lanmilab/flick_music/arduino/README.md

Source code for arduino [flick_music](https://www.hackster.io/lanmiLab/make-musical-instrument-using-arduino-and-flick-large-e2890b) project.
