lanmilab/flick_music/shield_pcb/Outputs/flick_music_bot.jpg

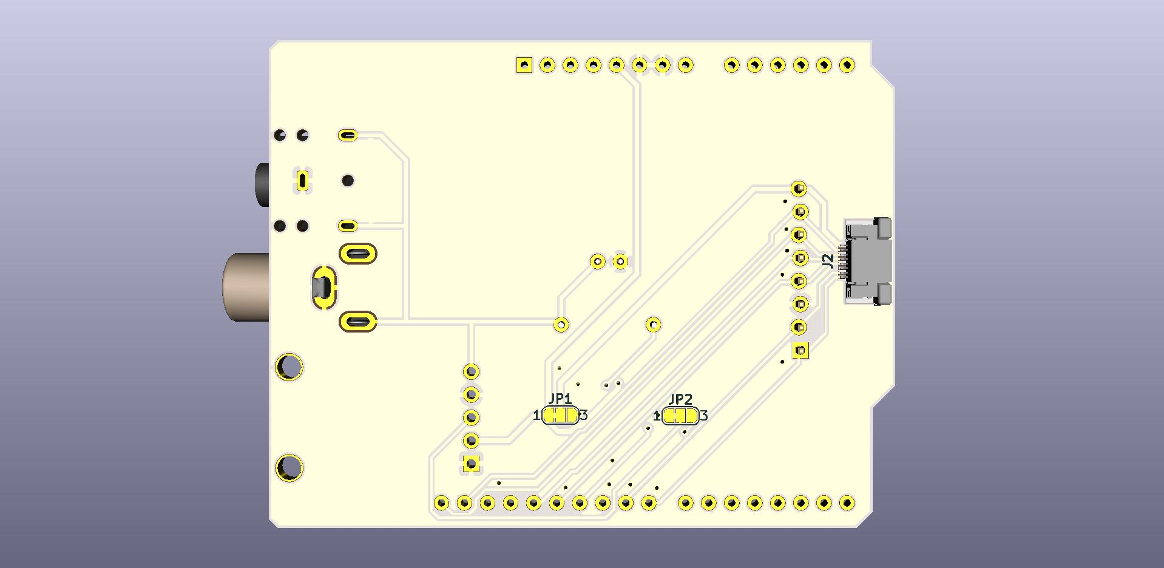
shield_pcb/Outputs/flick_music_bot.jpg
