lanmilab/flick_music/shield_pcb/Outputs/flick_music.pdf

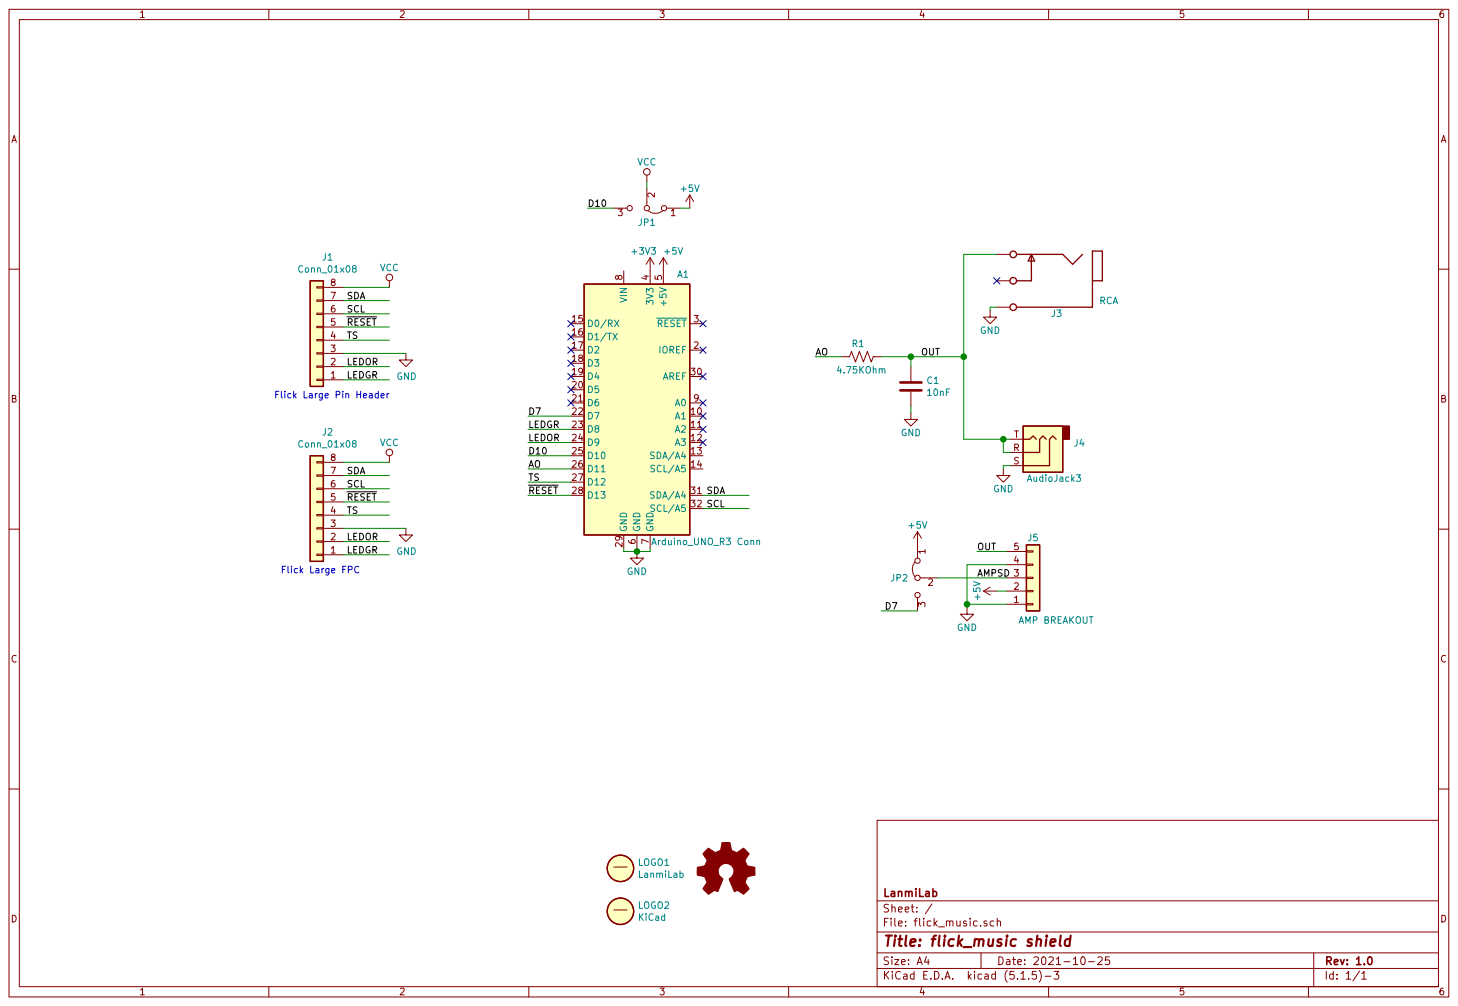
[picture p3: page 1]

Flick Large Pin Header

J5 AMP BREAKOUT GND GND GND

File: flick_music.sch Sheet: / LanmiLab
