lanmilab/flick_music/shield_pcb/flick_music.kicad_pcb

## KiCad design shield_pcb/flick_music.kicad_pcb (2021-10-25)

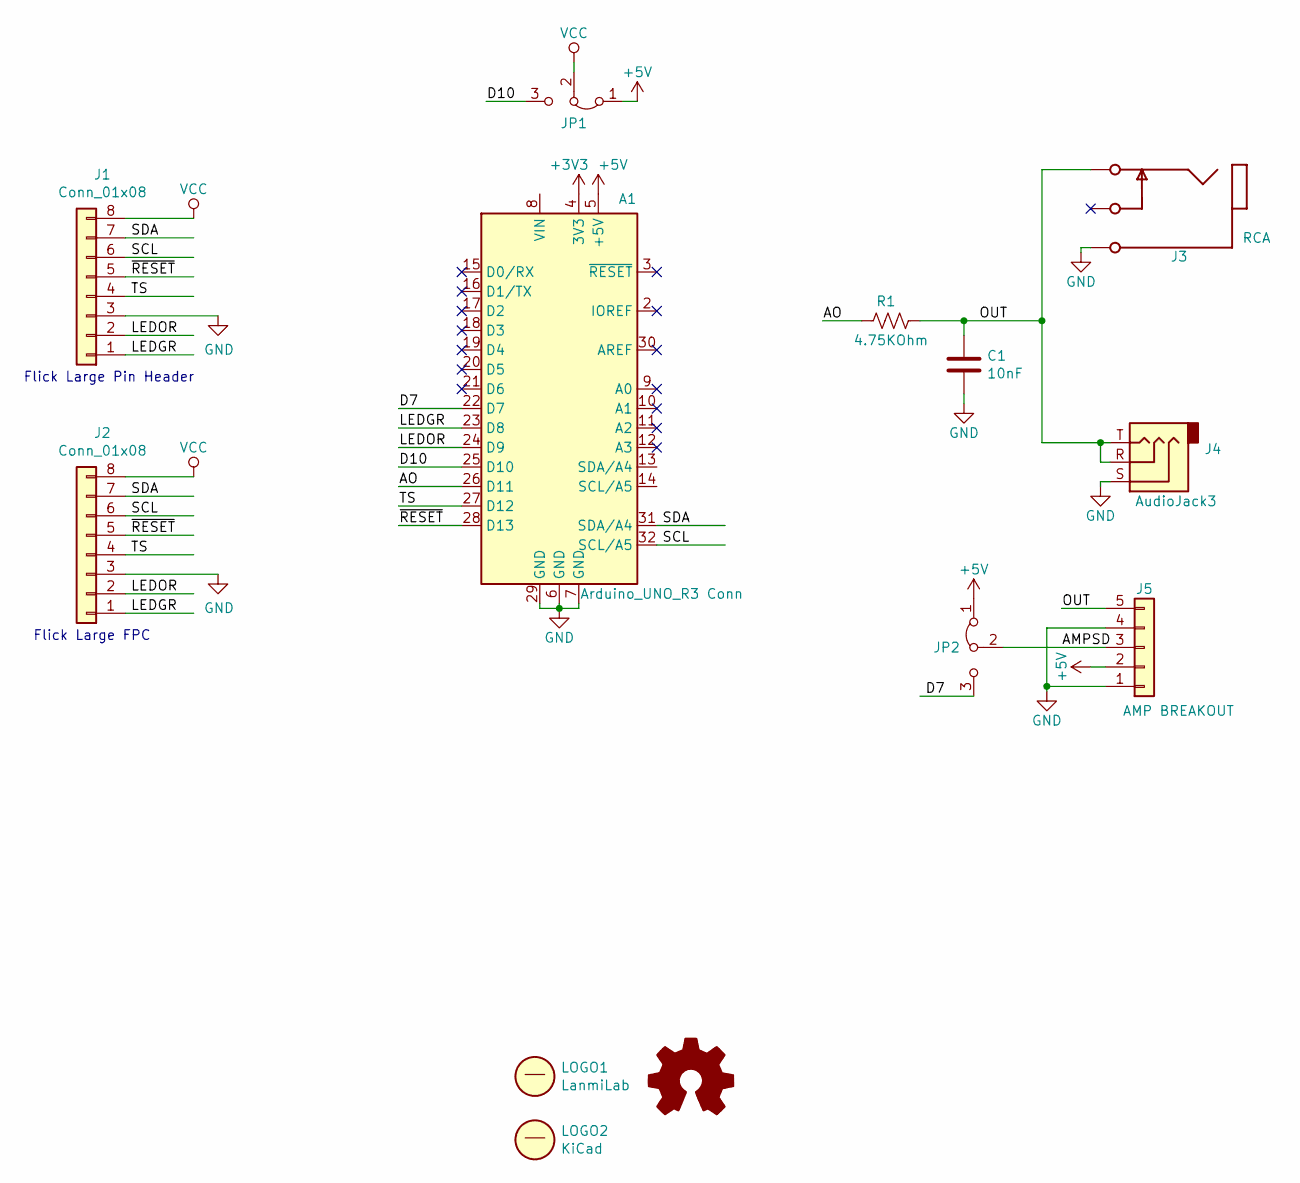
[picture p4: schematic flick_music.sch, flick_music shield]

Parts:
A1: Arduino_UNO_R3 Conn; Arduino_UNO_R3; Part Number M20-9994045
C1: 10nF; C_Disc_D3.8mm_W2.6mm_P2.50mm; Part Number C315C103K1R5TA
J1: Conn_01x08; PinHeader_1x08_P2.54mm_Horizontal; Part Number 68016-208HLF
J2: Conn_01x08; TE_0-1734839-8_1x08-1MP_P0.5mm_Horizontal; Part Number 0-1734839-8
J3: RCA; PJRAN1X1U01X; Part Number PJRAN1X1U01X
J4: AudioJack3; FC68131CLIFF; Part Number FC68131
J5: AMP BREAKOUT; PinSocket_1x05_P2.54mm_Vertical; Part Number PAM8302A Adafruit
JP1, JP2: Jumper_3_Bridged12; SolderJumper-3_P1.3mm_Bridged12_RoundedPad1.0x1.5mm_NumberL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
LOGO1: LanmiLab
LOGO2: KiCad; Logo_KiCad
LOGO3: Logo_Open_Hardware_Small; OSHW-Logo2_7.3x6mm_SilkScreen
R1: 4.75KOhm; R_Axial_DIN0207_L6.3mm_D2.5mm_P10.16mm_Horizontal; Part Number MCMF0W4FF4751A50

Connections:
+3V3: A1.4 (3V3)
+5V: A1.5 (+5V), J5.2, JP1.1 (A), JP2.1 (A)
/AMPSD: J5.3, JP2.2 (C)
/AO: A1.26 (D11), R1.2
/D7: A1.22 (D7), JP2.3 (B)
/D10: A1.25 (D10), JP1.3 (B)
/LEDGR: A1.23 (D8), J1.1, J2.1
/LEDOR: A1.24 (D9), J1.2, J2.2
/OUT: C1.1, J3.2, J4.R, J4.T, J5.5, R1.1
/SCL: A1.32 (SCL/A5), J1.6, J2.6
/SDA: A1.31 (SDA/A4), J1.7, J2.7
/TS: A1.27 (D12), J1.4, J2.4
/~RESET: A1.28 (D13), J1.5, J2.5
GND: A1.6 (GND), A1.7 (GND), A1.29 (GND), C1.2, J1.3, J2.3, J3.1, J4.S, J5.1, J5.4
VCC: J1.8, J2.8, JP1.2 (C)

Notes on the sheet:
Flick Large FPC
Flick Large Pin Header

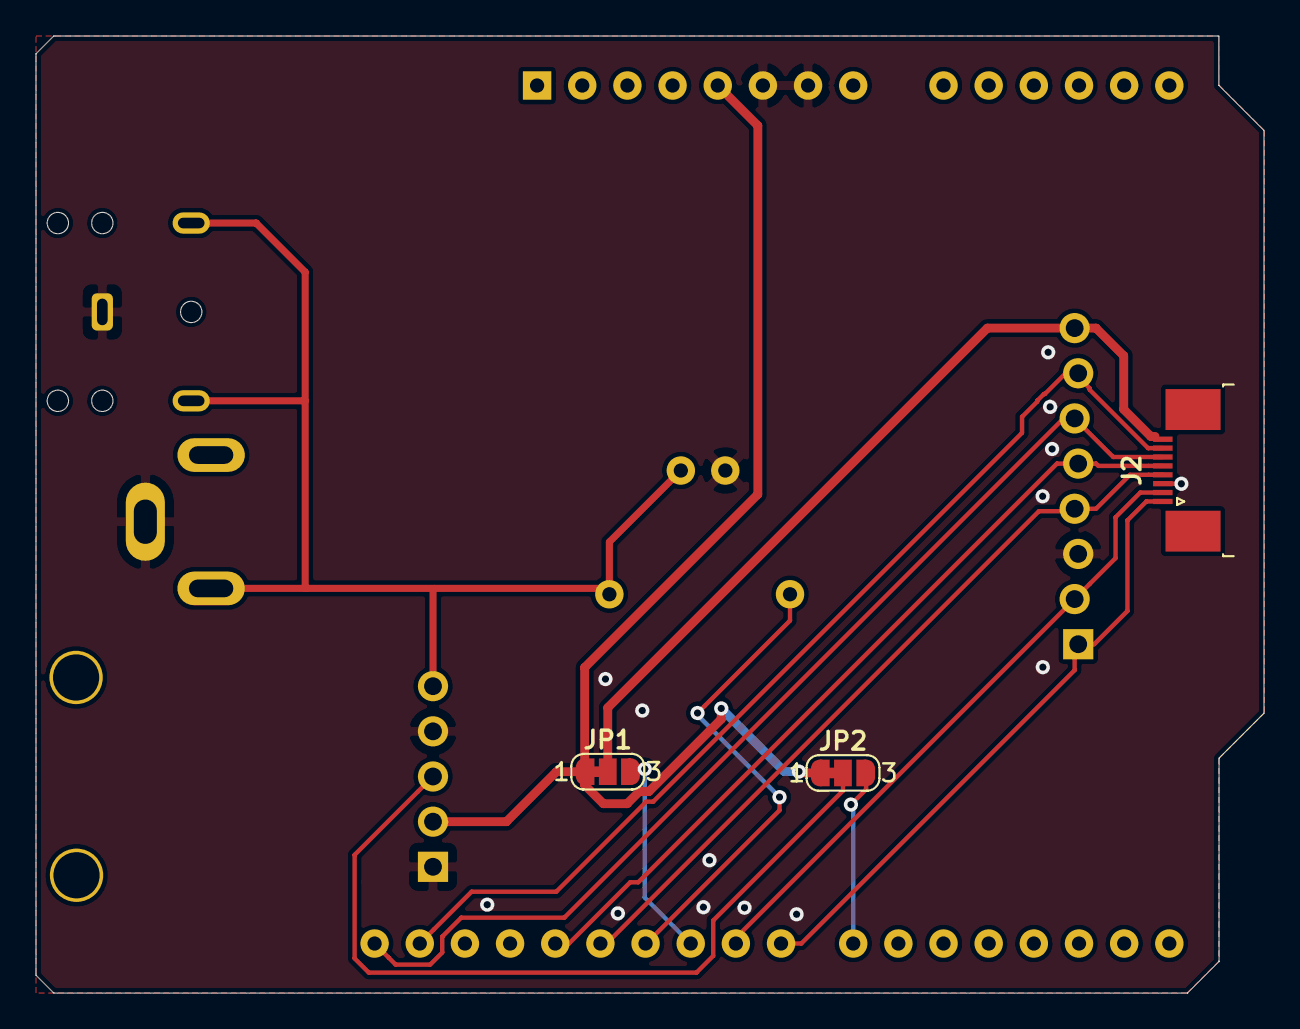
[picture p5: board flick_music.kicad_pcb from above]

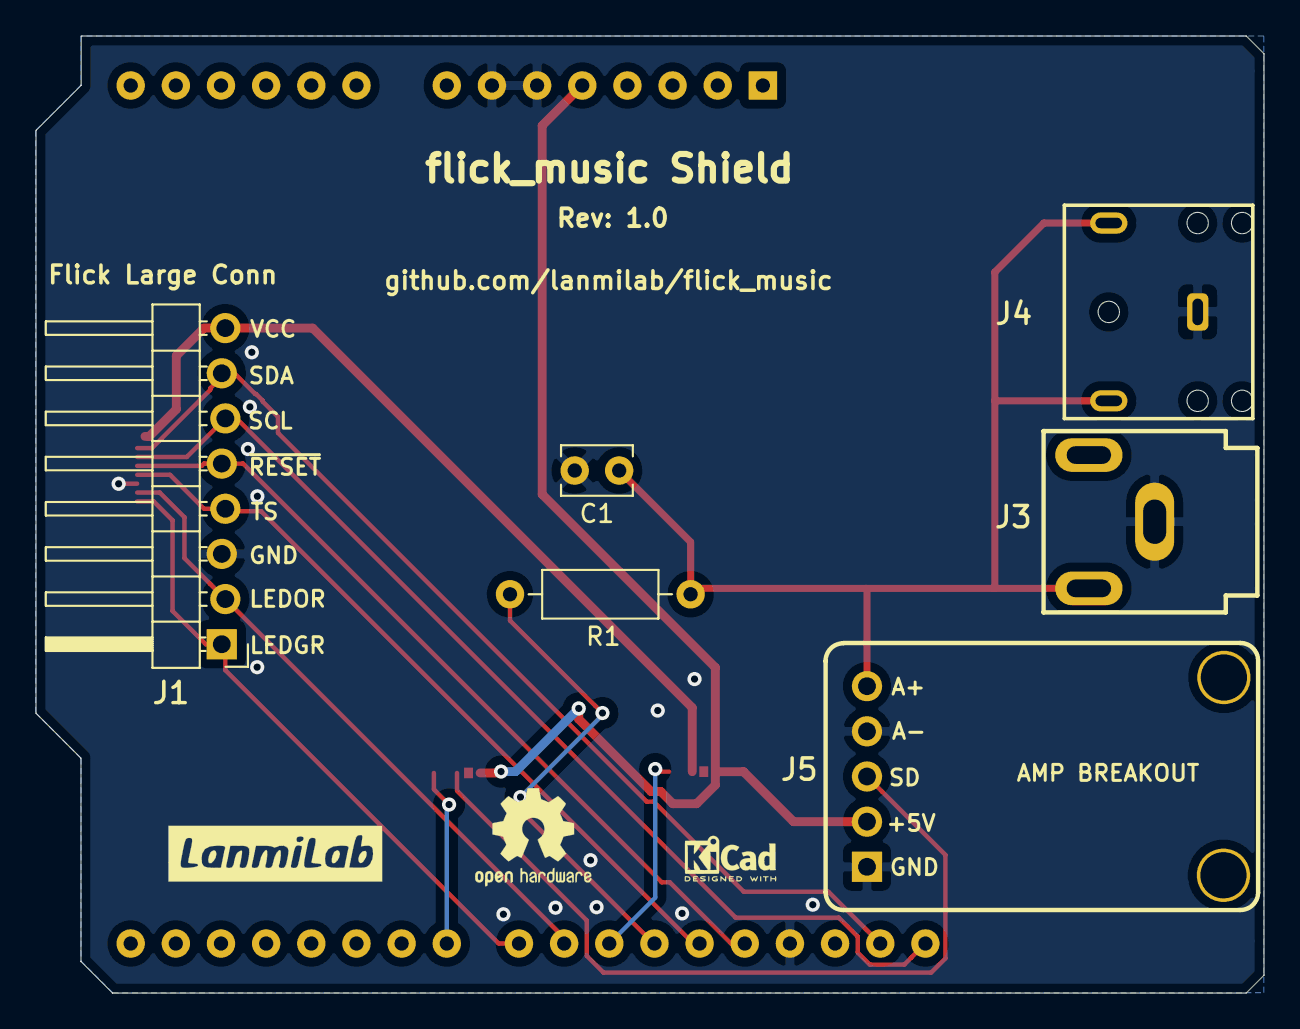
[picture p6: board flick_music.kicad_pcb from below]

Board: 2 copper layers, 69.1 x 53.8 mm, 13 parts (9 on the bottom side), 14 nets.
